eslamnafe742-crypto/geocentric/InnerPlanets.FCStd

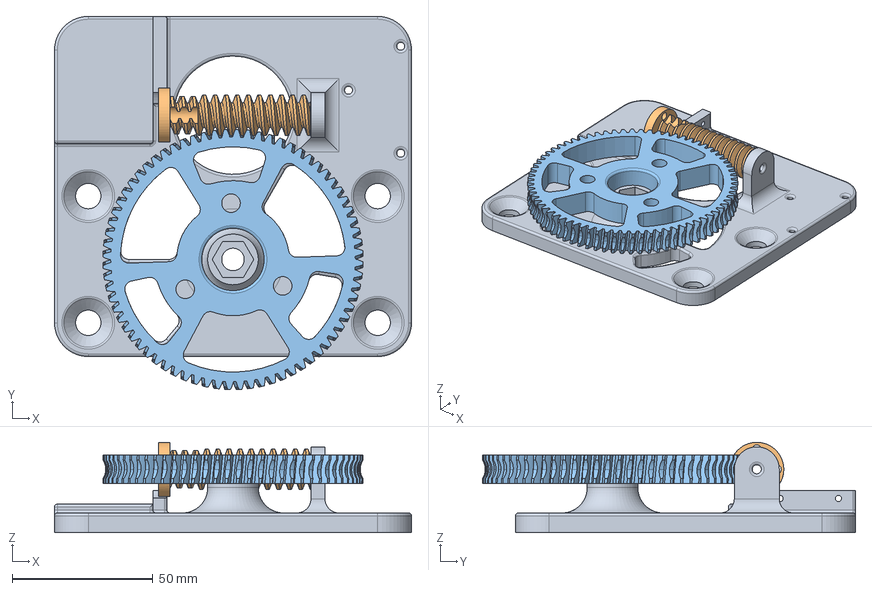
[picture p1: CAD file, 2026-07-01]
InnerPlanets.FCStd
126.8 x 132.6 x 32.1 mm
