eslamnafe742-crypto/geocentric/GearTest.FCStd

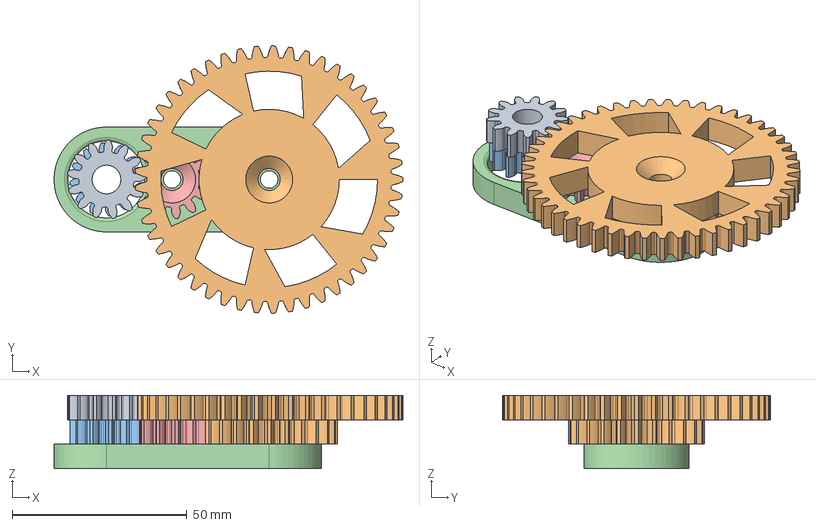
[picture p2: CAD file, 2026-06-16]
GearTest.FCStd
99.7 x 76.5 x 21.0 mm
