eslamnafe742-crypto/geocentric/(commit log)

2026-06-14 29:30+30:29 reducer test, goes the wrong way!
    [GearTest.FCStd]
2026-06-14 gear finder two stage
2026-06-14 epicyclic gear finder!
2026-06-16 found the moon gear
    [GearTest.FCStd]
2026-06-20 found gears, but mars and jupiter are too fast
2026-06-20 printed and mostly working!
    [InnerPlanets.FCStd]
2026-07-01 started on sts servo interface; have to hack a sleep mode to get 20 minutes per rev
2026-07-01 20 min/rev seems to work with custom wheel mode
2026-07-01 as printed and working
    [InnerPlanets.FCStd]
2026-07-01 slow motor
